amyjsph/Projet_arduino/cahier des charges.docx

CAHIER DES CHARGES :

Description du projet :

Notre projet consiste à reproduire un orgue nous permettant de jouer de différents instruments ( piano, batterie et synthétiseur ). Afin de le rendre accessible à tout le monde, nous ajouterons un mode « guidé » : après avoir choisi un morceau, l’orgue nous indiquera quelles notes jouer en éclairant les touches sur lesquelles appuyer.
