amyjsph/Projet_arduino/Rapports de séances/JOSEPH/rapport de séance_22.02.24.pdf

JOSEPH Amy G1 | Binôme : CARPENTIER Clarisse

## RAPPORT DE SEANCE :

## Séance n°8 - 22 février 2024

LED :

Malheureusement, après avoir terminé de souder nos deux bandes LED entre elles en début de séance, nous avons remarqué que les LEDs ne fonctionnaient plus (en effet l’une d’entre elles avaient sûrement grillé). Nous avons donc utilisé un nouveau ruban, souder trois câbles à l’entrée, puis coller les LED à l’intérieur de la structure.

Les LED ont par la suite été ajoutées au code du mode d’utilisation « jeu/guidé ». Pour cela, il a fallu importer la bibliothèque Adafruit_NeoPixel (nous n’avons pas encore terminé le code).

Les LED ont tout de même été testée à l’aide d’un autre code. Après avoir également découpé deux bandes pour « cacher » les LED à cause de leur forte intensité, voici le résultat obtenu :

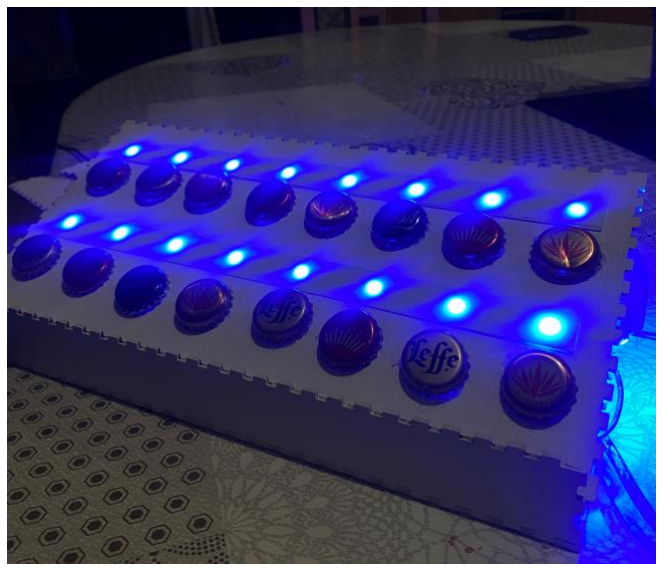
[picture p4: figure]
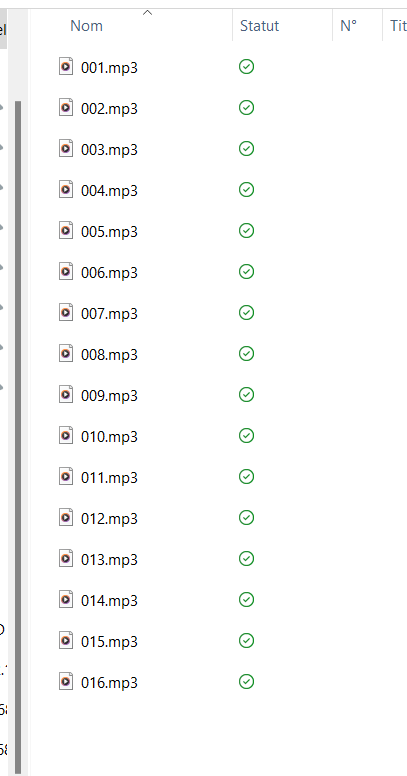
[picture p5: figure]

Nouvel instrument :

Nous avons décidé d’ajouter, en plus du piano et de la batterie, 16 notes de synthétiseur des années 80. Je me suis donc chargée de rechercher un site où télécharger ces notes sous format mp3.

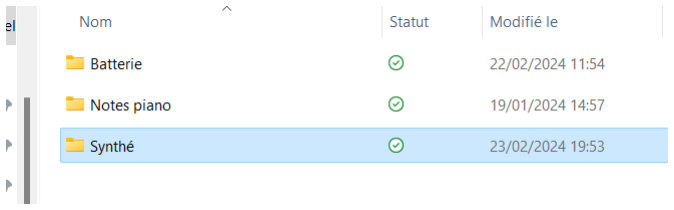
[picture p6: figure]
