amyjsph/Projet_arduino/Rapports de séances/CARPENTIER/Rapport de séance-CARPENTIER-08_02_2024.pdf

CARPENTIER Clarisse | Binôme : JOSEPH Amy
PEIP 2
G1

## Rapport de séance :

Séance du 08/02 :

Pendant les vacances, je me suis occupée de peindre en blanc notre structure en bois.

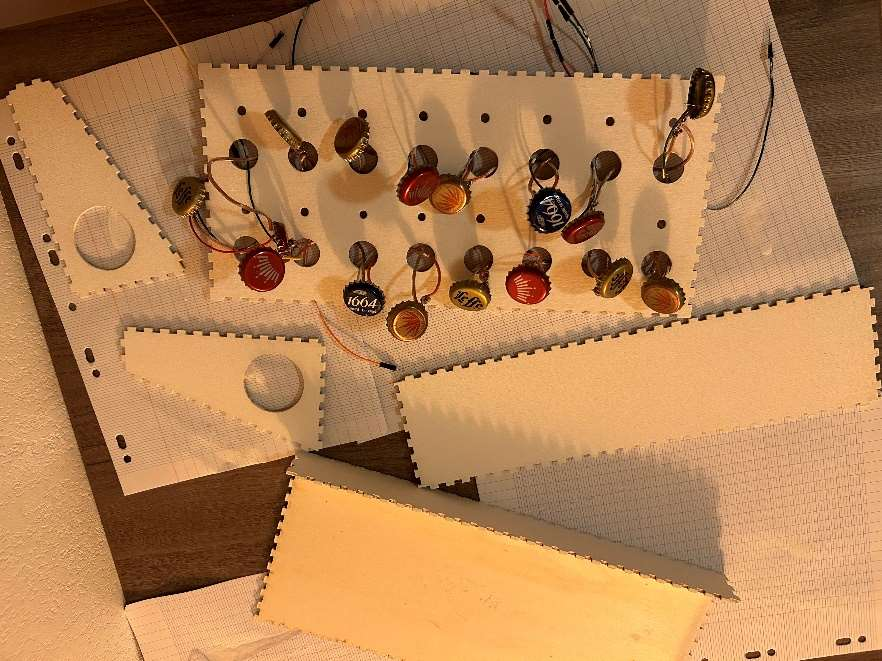
[picture p16: figure]

En début de séance, comme la peinture avait été réalisée, j’ai pu coller au pistolet à colle les capsules au support.

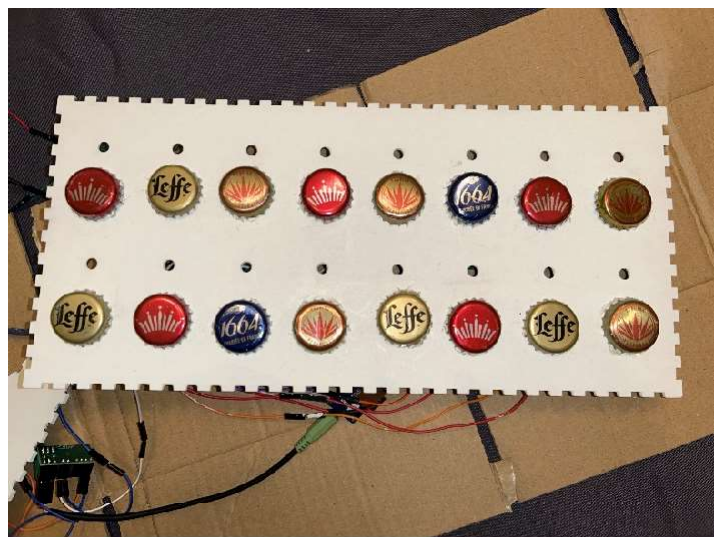
[picture p17: figure]

Le reste de la séance a été consacré à commencer à construire le mode guidé.

Nous souhaitons pour ce mode qu’une led au hasard parmi les seize s’allume afin d’indiquer au joueur sur quelle capsule appuyer. Tant que le joueur n’appuie pas sur la bonne capsule la led reste allumée. Une fois que le joueur a appuyé, la led s’éteint et une autre s’allume et ainsi de suite jusqu’ à ce qu’il ait fini de jouer le morceau qu’il a choisi.

Je me suis donc occupée de la pare code.

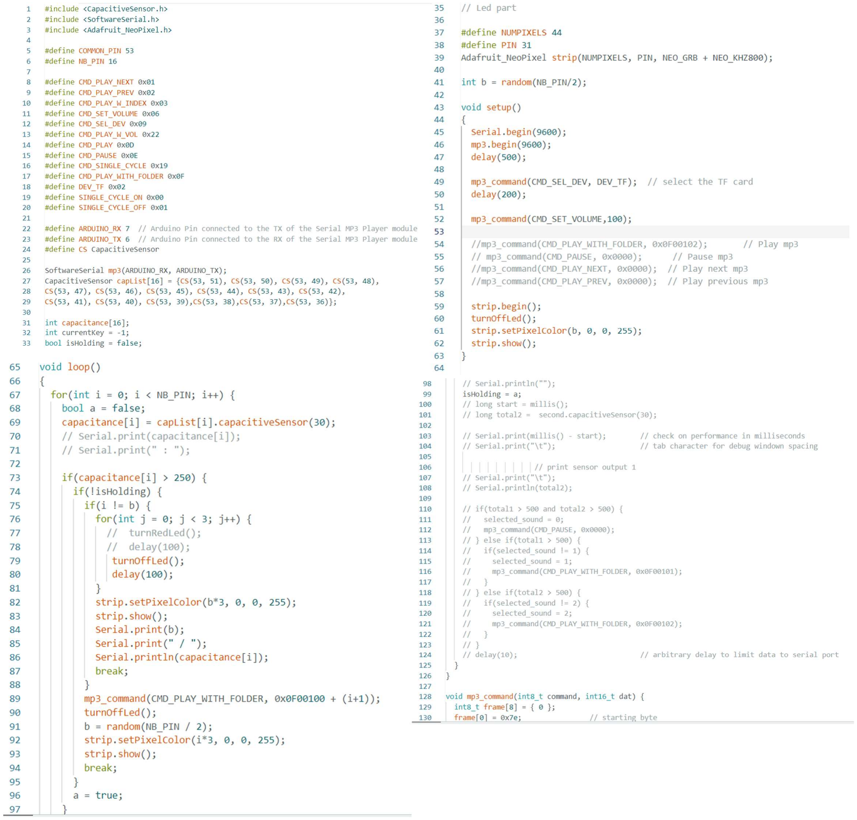
[picture p18: figure]

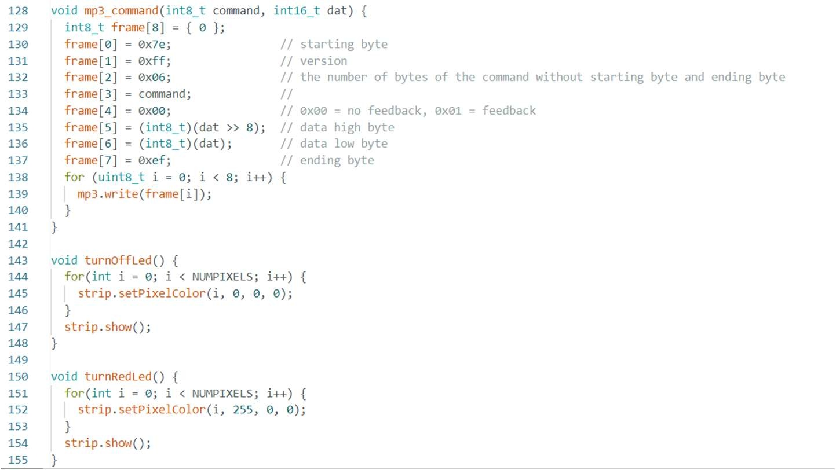
[picture p19: figure]

Pour le code je me suis inspirée du code que nous avait donné Mr Masson et je l’ai combiné avec le code réalisé par Amy avant les vacances.
J’ai ensuite mis les condions afin que les led s’allument quand on le souhaite.
Le nombre de pin est divisé par deux car pour l’instant nous avons testé qu’avec la moié des capsules et que la bande led du haut car nous avions peur que l’arduino ne puisse pas délivrer assez pour les haut-parleur ainsi que pour les leds.
De plus, lorsque nous appuyons sur la bonne capsule pour le moment c’est une note de piano qui sort. On devra donc à la prochaine séance remplacer les notes de piano par les morceaux de musique choisie.

A la fin de la séance nous avons donc regroupé nos travaux avec Amy.
La vidéo de démonstraon est disponible dans le dossier « RAPPORT DE SEANCE » « CARPENTIER ».
