amyjsph/Projet_arduino/Rapports de séances/JOSEPH/rapport de séance_25.01.24.pdf

## RAPPORT DE SEANCE :

## Séance n°5 - 25 janvier 2023

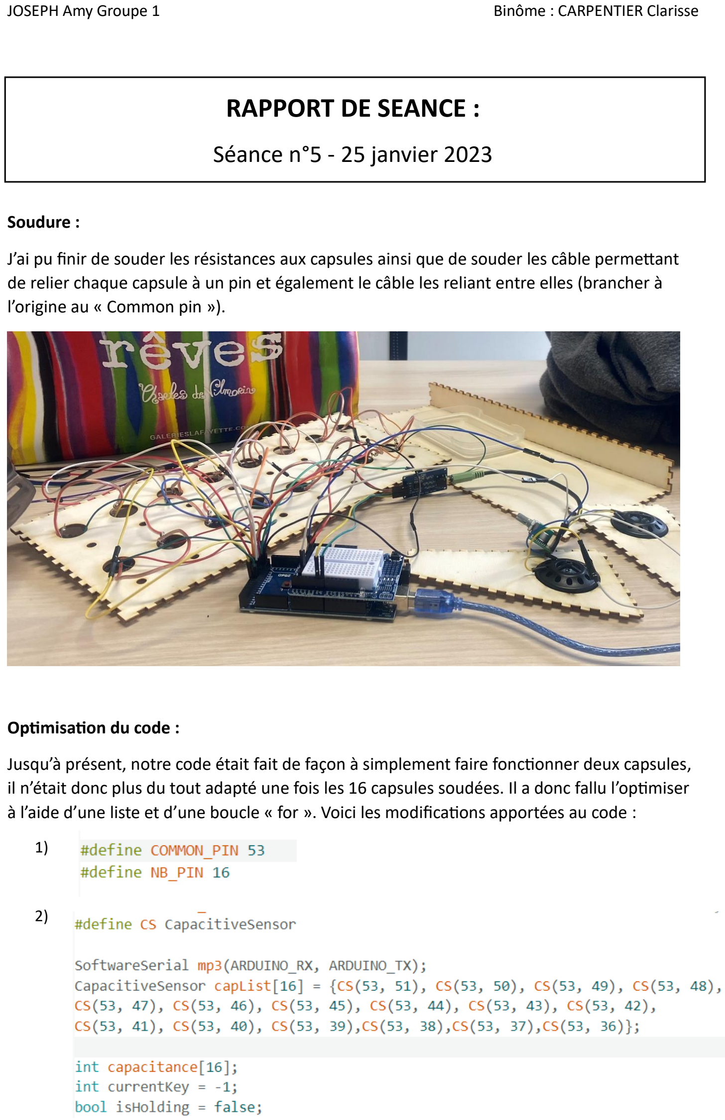
[picture p20: page 1]

JOSEPH Amy Groupe 1 | Binôme : CARPENTIER Clarisse

Soudure :

J’ai pu finir de souder les résistances aux capsules ainsi que de souder les câble permettant de relier chaque capsule à un pin et également le câble les reliant entre elles (brancher à l’origine au « Common pin »).

Optimisation du code :

Jusqu’à présent, notre code était fait de façon à simplement faire fonctionner deux capsules, il n’était donc plus du tout adapté une fois les 16 capsules soudées. Il a donc fallu l’optimiser à l’aide d’une liste et d’une boucle « for ». Voici les modifications apportées au code :

1)

2)

JOSEPH Amy Groupe 1 | Binôme : CARPENTIER Clarisse

3)

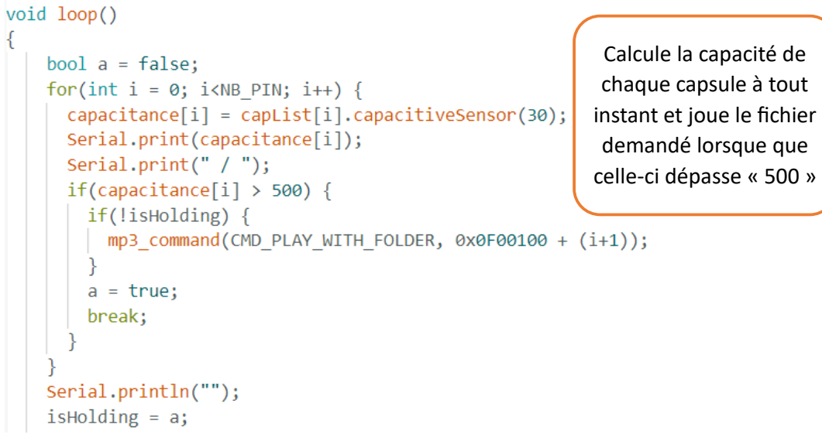
[picture p21: figure]
Calcule la capacit chaque capsule à tout instant et joue le fichier demandé lorsque que celle; ci dépasse

| é de
