amyjsph/Projet_arduino/Rapports de séances/CARPENTIER/Rapport de séance-CARPENTIER-25_01_2024.pdf

CARPENTIER Clarisse | Binôme : JOSEPH Amy
PEIP 2
G1

## Rapport de séance :

Séance du 25/01 :

J’ai commencé cee séance par mesurer le diamètre des hauts parleurs afin de connaître la taille des trous à faire sur les planches du côté de notre structure pour les faire passer. J’ai ensuite tracé les trous sur les planches et je suis allée au FabLab pour les découper au laser. Une fois les trous découpés, j’ai du les poncer un peu car il manquait même pas un millimètre pour que les hauts parleurs puissent passer.
Voici le résultat :

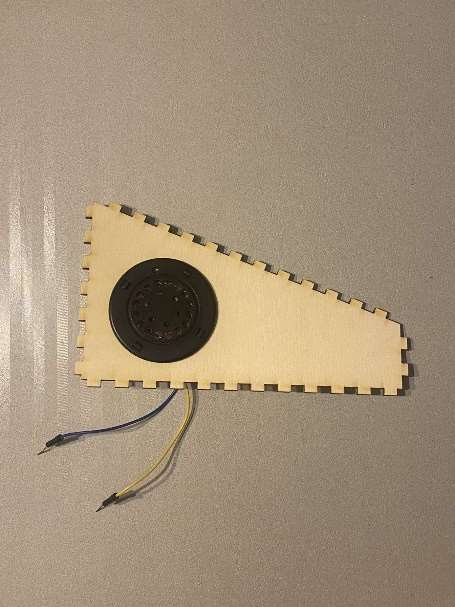
[picture p22: figure]
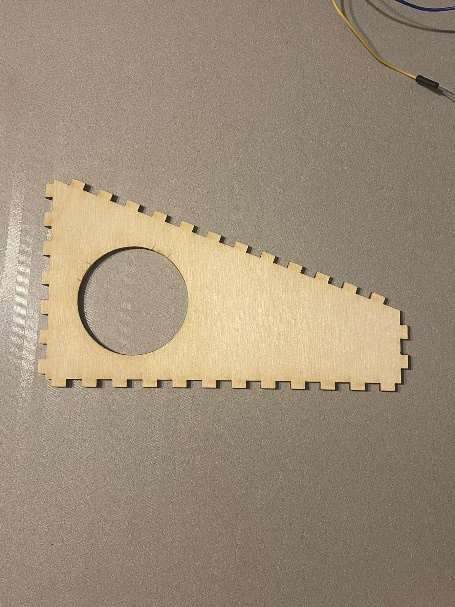
[picture p23: figure]

Ensuite je me suis occupée des leds.

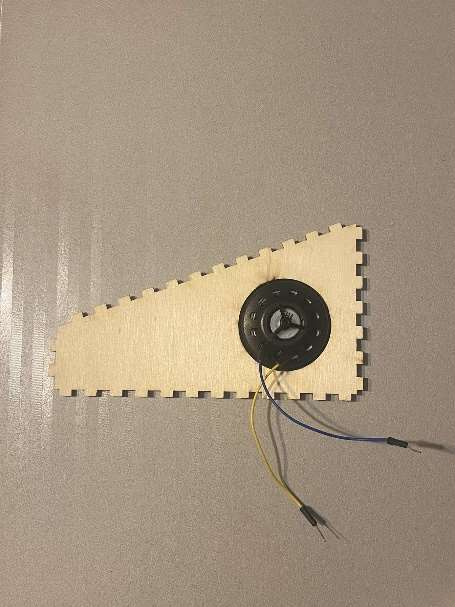
[picture p24: figure]

Pour notre projet, nous avons choisi de mere un mode guidé : le joueur choisit la musique qu’il souhaite jouer puis, une led s’allume afin d’indiquer au jouer sur quelle capsule appuyer. Une fois que le joueur a appuyé sur la capsule dont la led est allumée, celle-ci s’éteint et une autre s’allume et ainsi de suite jusqu’à avoir recomposer la musique.
Malheureusement, nous n’avons pas ancipé et avons laissé un trop grand espace entre les trous pour les leds et donc nous ne pouvons pas juste uliser un ruban leds tel quel mais nous avons du couper le ruban afin de toutes les séparer.

Une fois cee étape faite, j’ai passé le reste de la séance à souder sur les leds les câbles qui permeront de les relier entre elles. C’est très long à faire car il faut faire aenon que les soudures de chaque câble ne se touchent pas.
Voici un exemple sur une led :

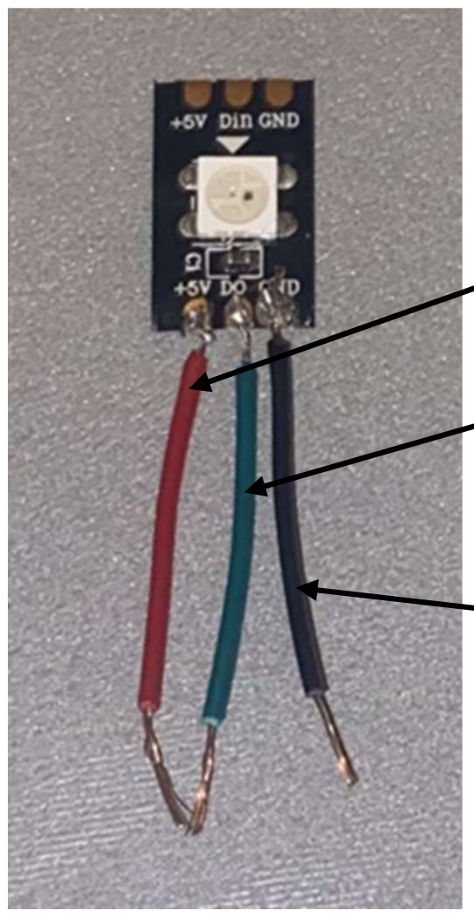
[picture p25: figure]

5V

Câble branché sur une entrée/sore digitale

Ground
