amyjsph/Projet_arduino/Rapports de séances/JOSEPH/rapport de séance_19.01.24.pdf

JOSEPH Amy Groupe 1 | Binôme : CARPENTIER Clarisse

## RAPPORT DE SEANCE :

## Séance n°4 - 19 janvier 2023

Combiner Capacitive Sensing et Restitution du son :

La séance d’aujourd’hui consistait à réussir à restituer du son lorsque nous touchions les capsules. Pour celà, nous avons combiner notre travail sur le Capacitive Sensing, effectué avant les vacances, et sur la restitution du son. Clarisse s’est occupée du montage pendant que je me chargait du code.

Pour le code, je me suis inspirée des exemples de code trouvés dans les deux bibliothèques
« CapacitiveSensor.h » et « SoftwareSerial.h » et j’ai fini par obtenir le code ci-dessous :

( certaines lignes de codes sont déjà expliquées en commentaire )

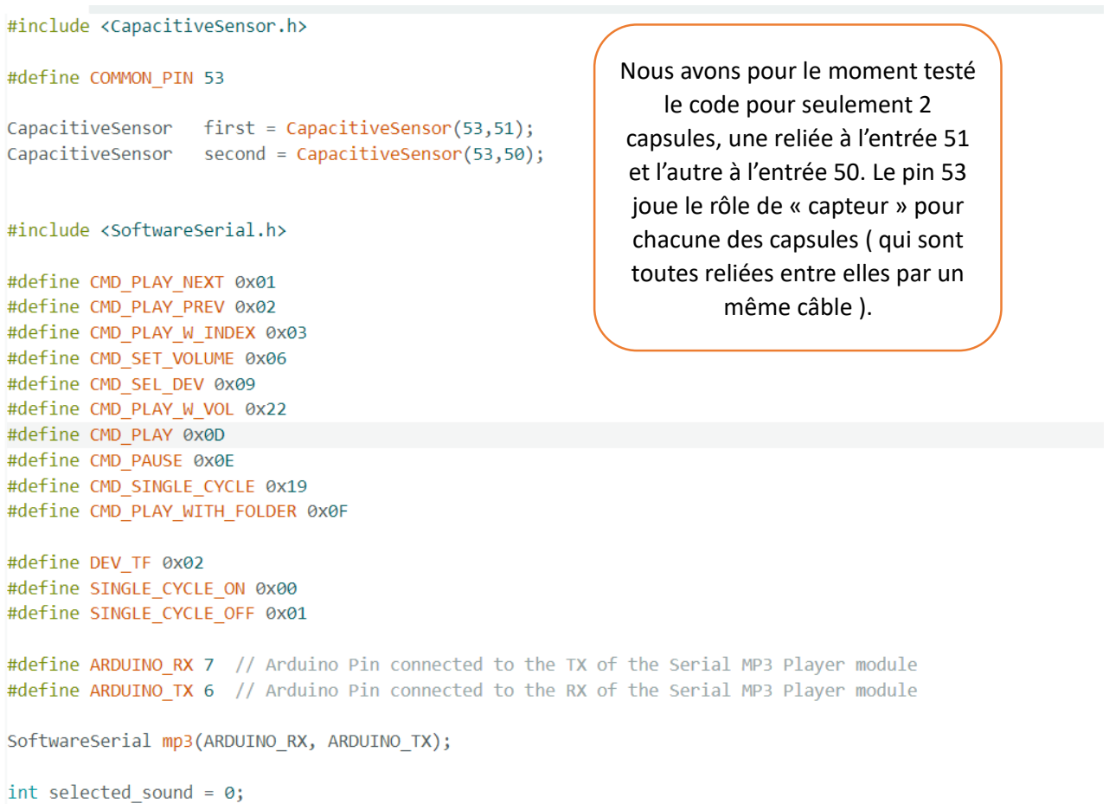
[picture p26: figure]
Nous avons pour le moment testé le code pour seulement 2 capsules, une reliée à l’entrée 51 et l’autre à l’entrée 50. Le pin 53 joue le rôle de « capteur » pour chacune des capsules ( qui sont toutes reliées entre elles par un même câble ).
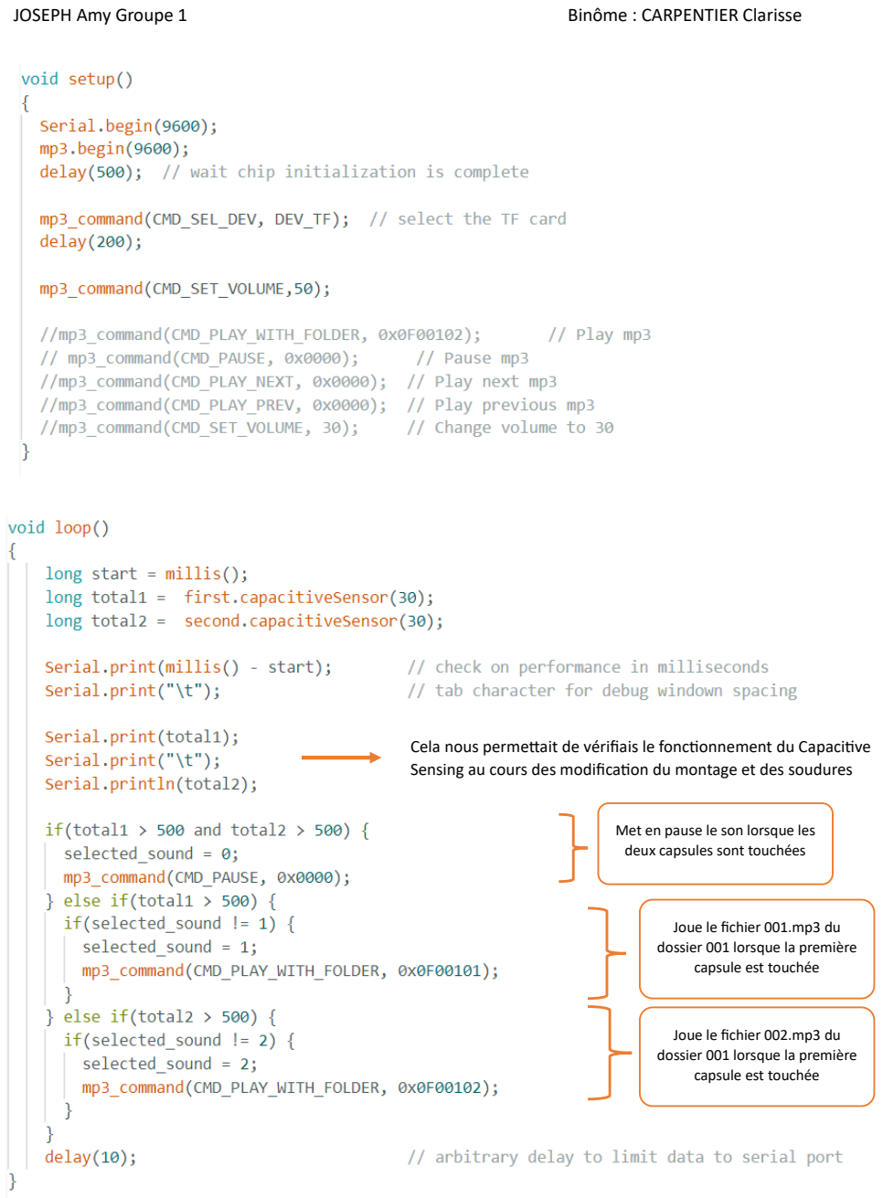
[picture p27: page 2]

Met en pause le son lorsque les deux capsules sont touchées

Joue le fichier 001.mp3 du dossier 001 lorsque la première capsule est touchée

Joue le fichier 002.mp3 du dossier 001 lorsque la première capsule est touchée

Cela nous permettait de vérifiais le fonctionnement du Capacitive Sensing au cours des modification du montage et des soudures

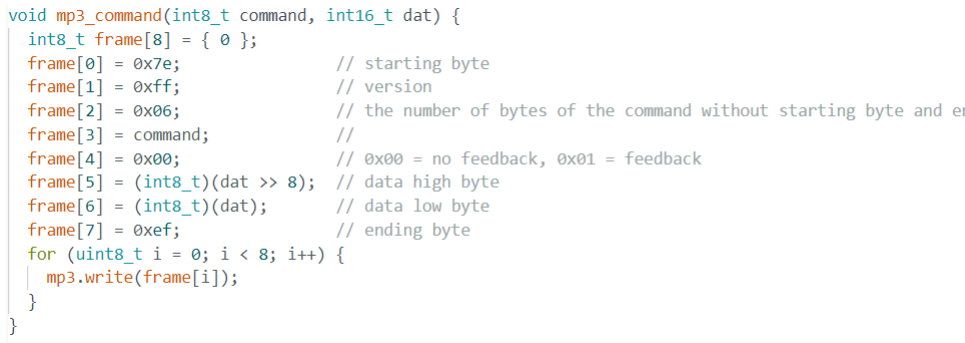
[picture p28: figure]

Il a fallu d’abord tester le fonctionnement avec les sons procurés par le professeur lorsque la carte SD nous a été prêtée, puis, une fois nos 16 fichiers sons trouvés pour nos 16 notes de piano différentes, nous avons pu les ajouter dans la carte SD.

Le code sera perfectionné la semaine prochaine en utilisant de listes et de boucles « for » une fois toutes les autres capsules ajoutées.

Soudure :

J’ai également passé les 45 dernière minutes de la séance à tenter de souder les résistances aux capsules restantes ( et cela est toujours aussi compliqué, l’étain tenant très difficilement sur les capsules ).
