amyjsph/Projet_arduino/Rapports de séances/CARPENTIER/Rapport de séance-CARPENTIER-22_12_2023.pdf

CARPENTIER Clarisse | Binôme : JOSEPH Amy
PEIP 2
G1

## Rapport de séance :

Séance du 22/12 :

Objecf de la séance : Ecrire le code pour tester notre projet avec une capsule.

Cee séance nous nous sommes intéressées au « capacity touch ». Dans notre cas, c’est notre corps et la capsule qui joue le condensateur. L’arduino va mesurer en combien de temps le condensateur se charge, ce qui va lui permere de calculer la capacité de celui-ci et donc permere de déterminer la valeur de la résistance dont nous avons besoin (Amy s’est occupée de cee pare).
Notre but est que lorsque qu’une capsule est touchée un son sorte.
Dans un premier temps nous avons fait le test avec une capsule et lorsque celle-ci était touchée une led devait s’allumer.
Je me suis d’abord penchée sur la pare code. J’ai donc commencé par chercher sur internet et j’ai trouvé un site( Capacive-Touch Arduino Keyboard Piano : 10 Steps (with Pictures) -Instructables) où il donnait un exemple de code. Je me suis rendue compte qu’il fallait télécharger la bibliothèque CapSense, ce que j’ai fait. Le code par contre ne fonconnait pas donc j’ai écrit un nouveau code :

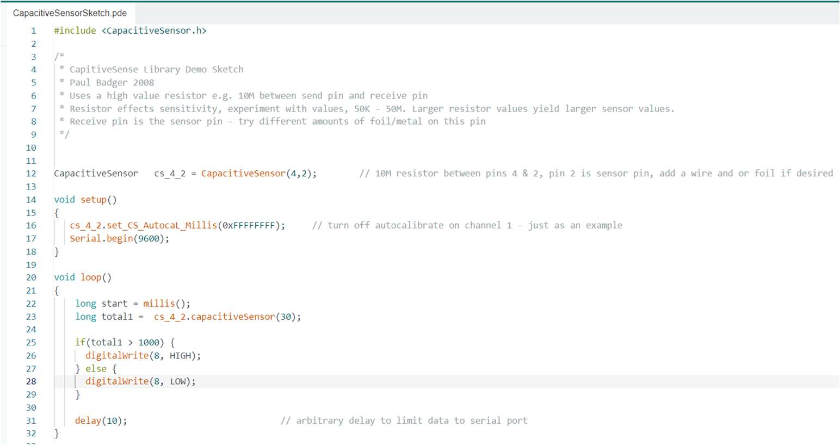
[picture p31: figure]

Explicaon du code : J’ulise la librairie CapSense qui donne la capacitance. Une fois la capacitance récupérée, je fais allumer la led lorsque la capacitance aeint un certain niveau (1000). Lorsque la capacitance est au-dessous de ce niveau la led s’éteint.

J’ai ensuite fait les branchements de la led. Puis, nous avons mis en commun, avec Amy, nos montages ainsi que le code afin de tester si tout marchait. Au moment de l’importaon du code dans l’arduino, je me suis rendue compte que je n’avais pas téléchargé le driver. Une fois le driver téléchargé, nous avons obtenu le résultat suivant :

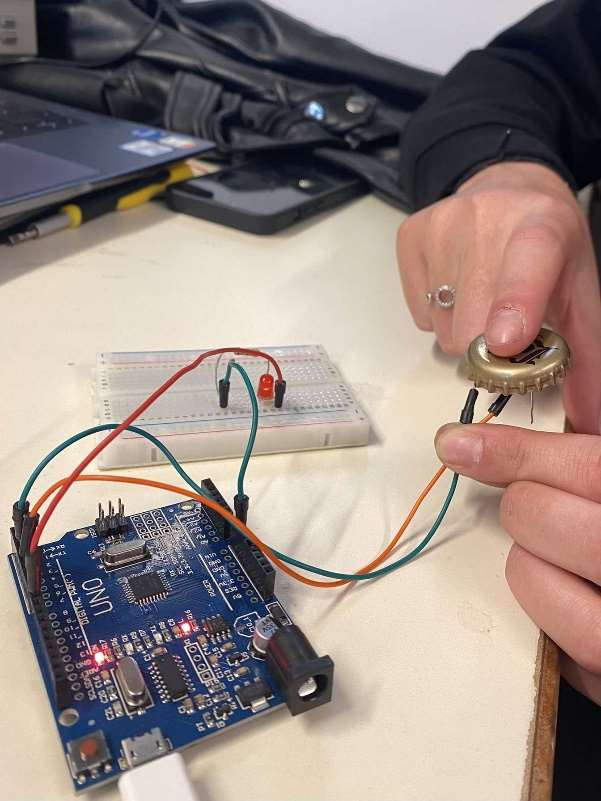
[picture p32: figure]
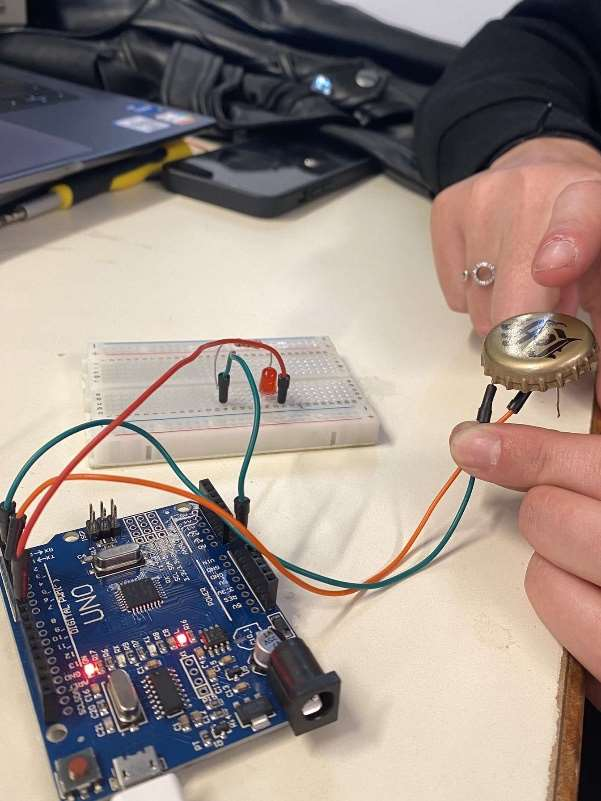
[picture p33: figure]

Led éteinte | Led allumée
