amyjsph/Projet_arduino/diapo arduino.pdf

## Soutenance orale de projet Arduino :

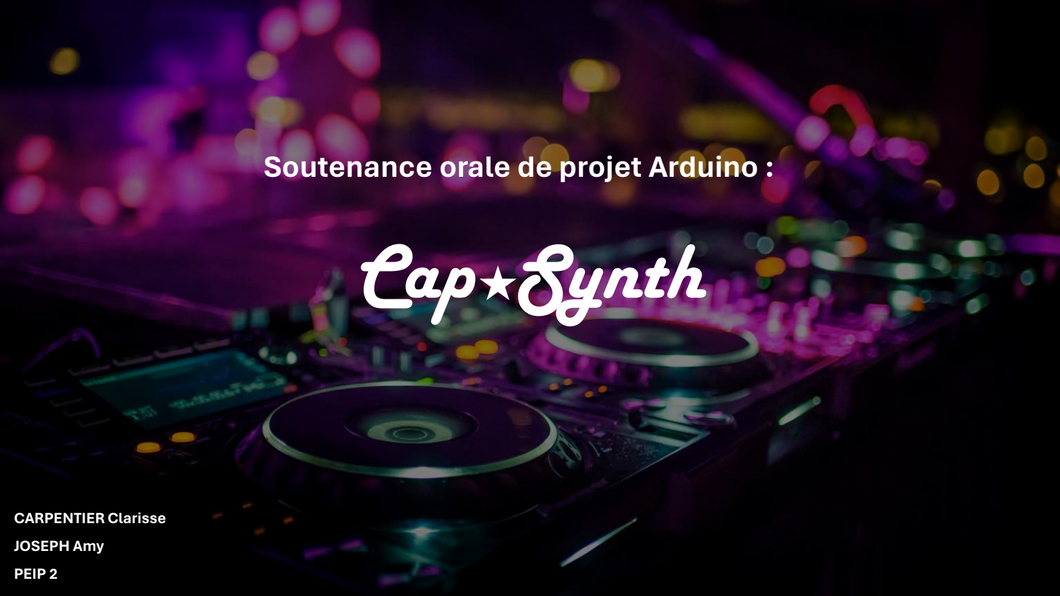
[picture p39: page 1]

# Cap Synth

CARPENTIER Clarisse
JOSEPH Amy
PEIP 2

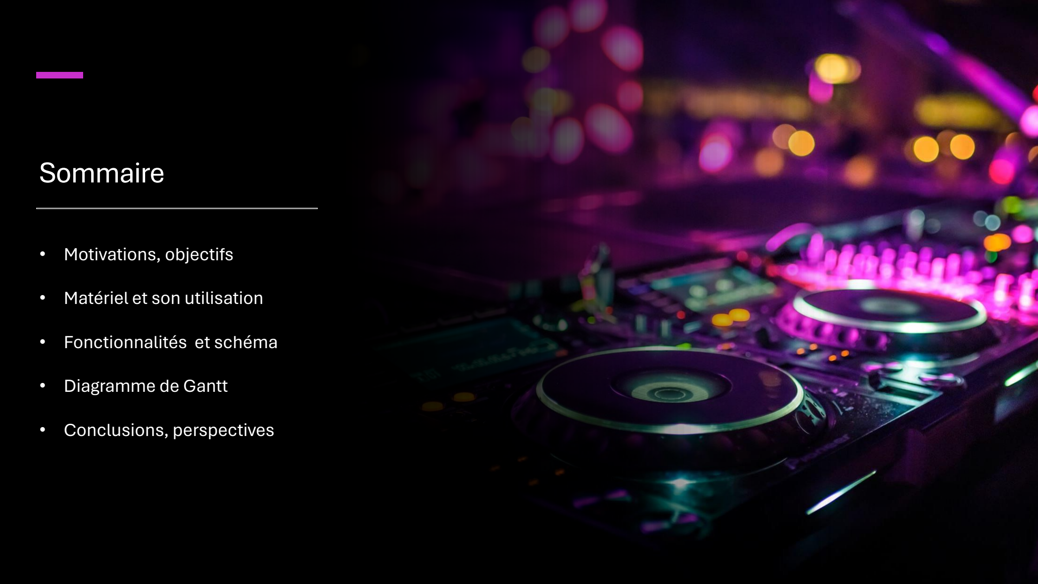
[picture p40: page 2]

## Sommaire

- Motivations, objectifs
- Matériel et son utilisation
- Fonctionnalités et schéma
- Diagramme de Gantt
- Conclusions, perspectives

# Motivations & objectifs

Objectifs:
Créer de la
musique de façon originale

Créer un instrument tactile avec la méthode du Capacitive sensing

Motivations:
Projet correspondant à nos personnalités et en rapport avec nos centres d’intérêt, par exemple, la musique

Créer un objet divertissant et ludique
et dynamique qui donne envie d’être essayé par tous.

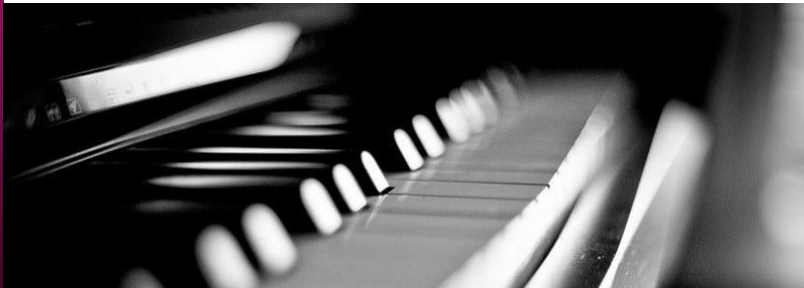
[picture p41: figure]
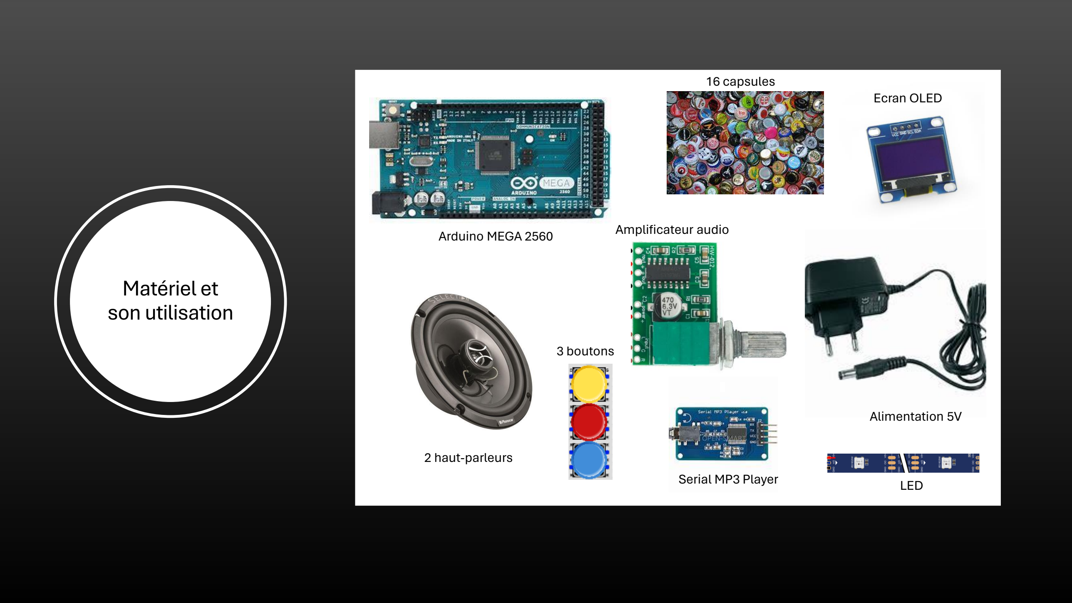
[picture p42: page 4]

Matériel et
son utilisation

Serial MP3 Player

16 capsules

Arduino MEGA 2560 | Amplificateur audio

Alimentation 5V

3 boutons

2 haut-parleurs

Ecran OLED

LED

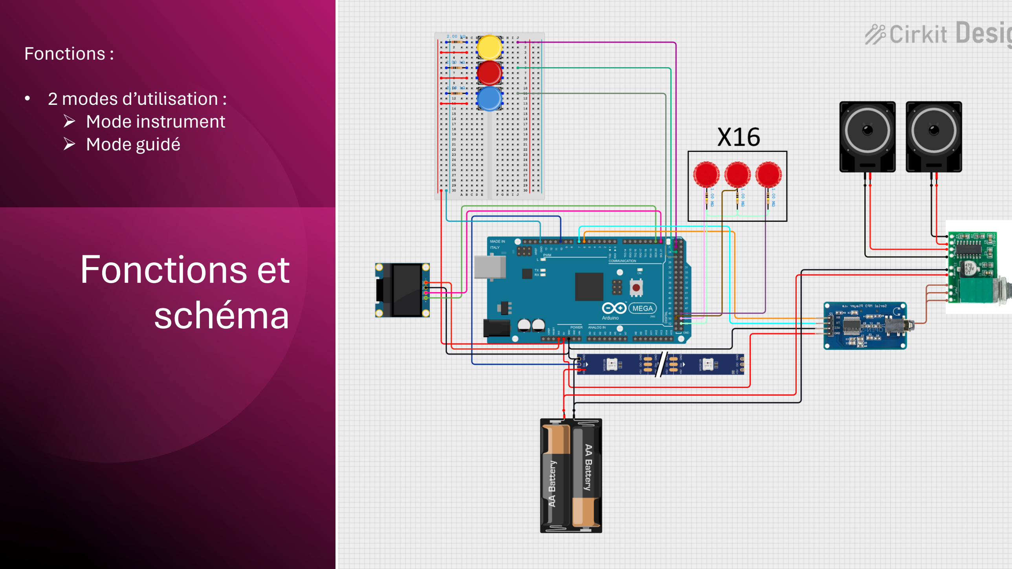
[picture p43: page 5]

# Fonctions et schéma

Fonctions :

- 2 modes d’utilisation :
- Mode instrument
- Mode guidé

# Diagramme de Gantt

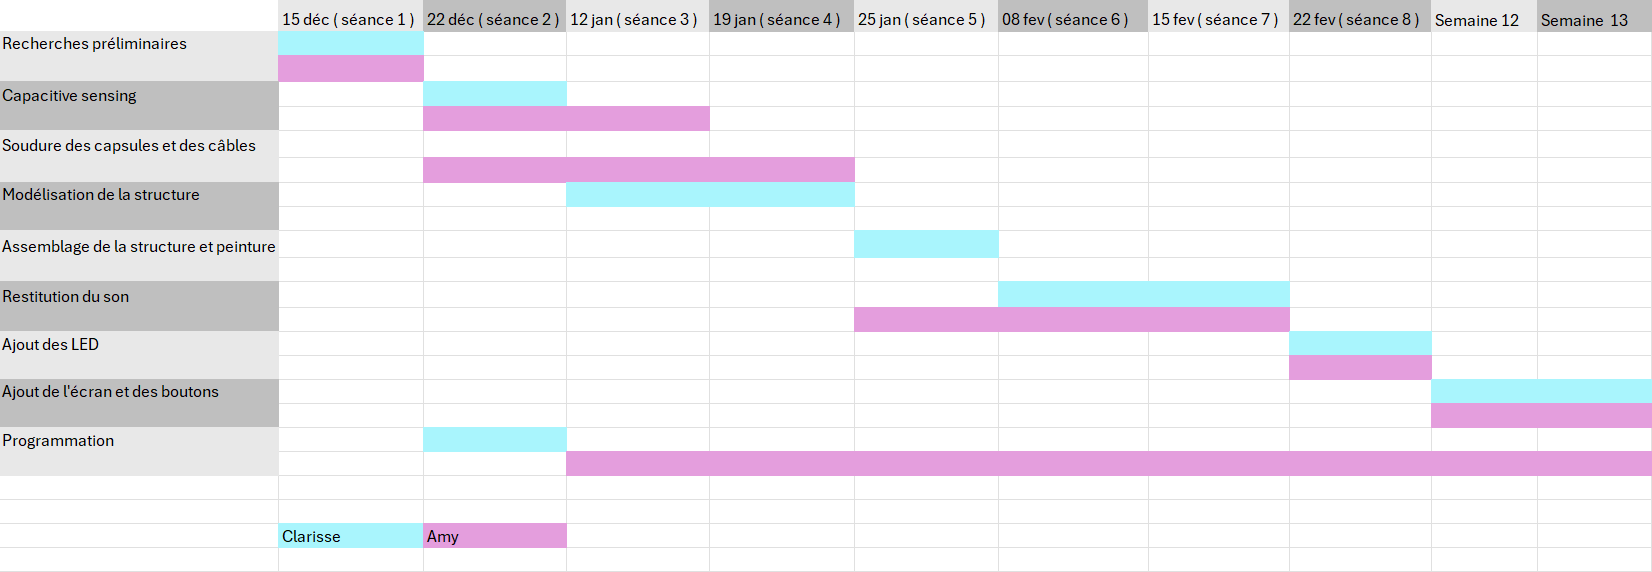
[picture p44: figure]
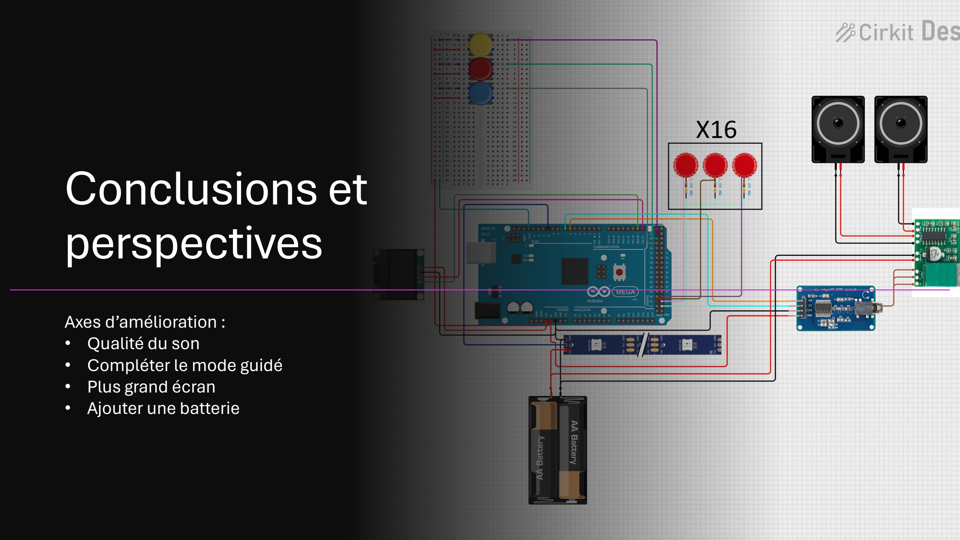
[picture p45: page 7]

# Conclusions et perspectives

Axes d’amélioration :
- Qualité du son
- Compléter le mode guidé
- Plus grand écran
- Ajouter une batterie
