amyjsph/Projet_arduino/Rapports de séances/CARPENTIER/Rapport de séance-CARPENTIER-12_01_2024.pdf

CARPENTIER Clarisse | Binôme : JOSEPH Amy
PEIP 2
G1

## Rapport de séance :

Séance du 12/01 :

Travail fait pendant les vacances :

Pendant les vacances avec Amy, nous avons réfléchi à comment insérer le ruban led à notre projet. Nous avons donc décidé de le coller au-dessous des planches sur lesquelles seront collées les capsules afin de pouvoir cacher tout le câblage. Pour que les lumières des leds puissent être visibles nous avons décidé de créer une rangée de trous (derrière celle pour les capsules) avec des trous de dimension 0,6cm (ce qui est la taille d’une led).
J’ai donc modélisé notre idée sur OnShape :

Travail fait lors de la séance :

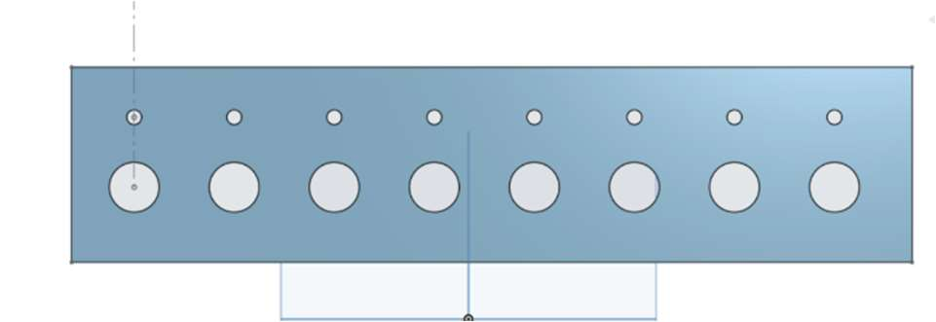
[picture p51: figure]

En début de séance nous avons, avec Amy, poncé l’intérieur des capsules afin que l’étain puisse mieux accrocher lors de la soudure.
Je suis ensuite aller voir la FabLab afin de savoir si il était possible de découper les pièces en bois dont on avait besoin pour créer notre escalier. On m’a alors dit qu’on ne pouvait pas faire un escalier car lors de l’assemblage les pièces ne endraient pas entre elles et que même avec de la colle forte ce ne serait pas assez solide.
J’ai donc cherché un nouveau modèle sur le site suivant : Gallery - Boxes.py (fes.info) (il m’a était conseillé par le FabLab)
Avec Amy nous avons donc décidé de parr finalement sur ce modèle :
(Console - Boxes (fes.info))

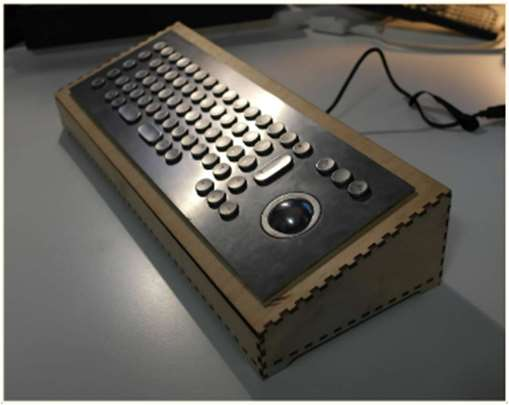
[picture p52: figure]

Une fois le modèle choisit, j’ai entré les dimensions dont on avait besoin ainsi que l’angle afin d’avoir la pente que nous souhaions.

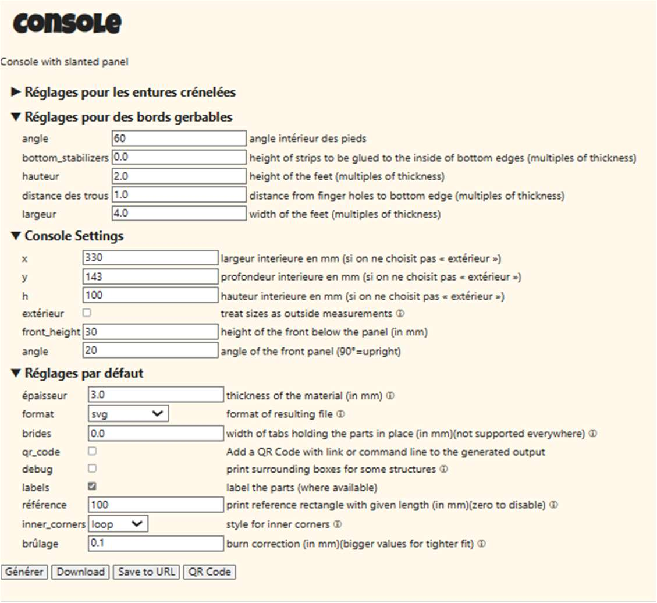
[picture p53: figure]

Une fois les mesures entrées j’ai généré un modèle de coupe. Je l’ai ensuite récupéré et importé sur le logiciel InkScape afin de modéliser nos rangées de trou. Je n’ai pas modélisé les trous sur les côtés desnés aux haut-parleurs car nous ne connaissons pas encore la tailles de ceux qu’on va uliser.

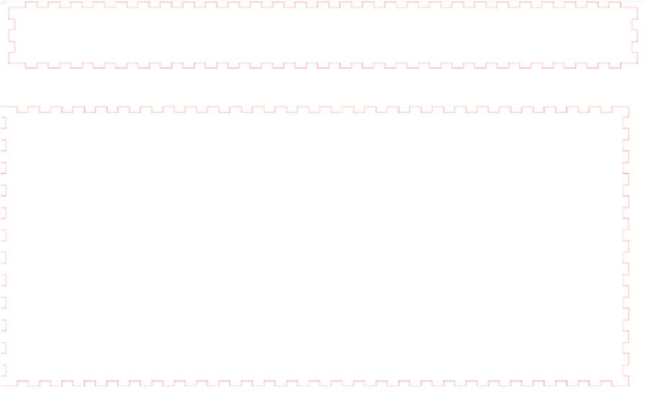
[picture p54: figure]
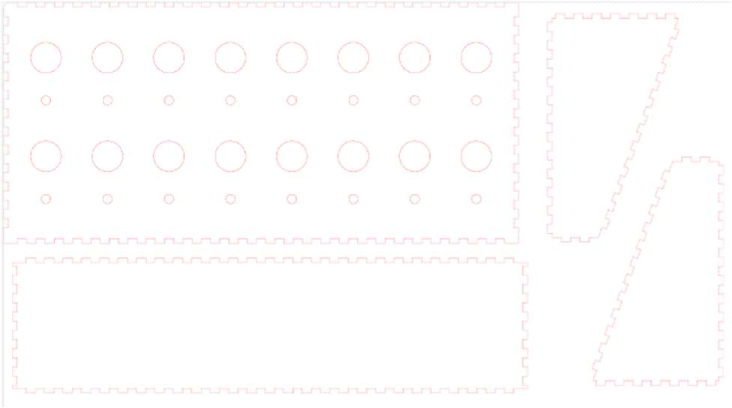
[picture p55: figure]

Je suis ensuite retournée au FabLab afin de faire découper les pièces.

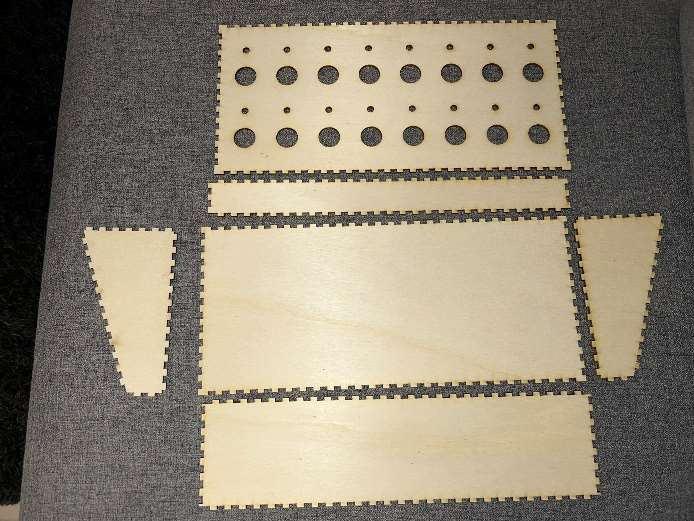
[picture p56: figure]

En fin de séance j’ai commencé à chercher des notes de piano que l’on pourrait converr en mp3 pour créer le mode piano. J’ai trouvé deux sites : 24 piano keys : Free Download, Borrow, and Streaming : Internet Archive et Freesound - 88 piano keys, long reverb by TEDAgame .
