amyjsph/Projet_arduino/(commit log)

2023-12-15 test led
2024-01-26 rapport de séance
2024-02-09 Create rapport de séance_08.02.24.pdf
2024-03-20 rapport et planning v1
    [Planning_projet_version1.xlsx, Planning_projet_version_finale.xlsx, Planning_v1_diagramme de Gaant.xlsx]
